brenn/kicad-filament-dryer/kicad/datasheets/MiniLCD-dimensions.gif

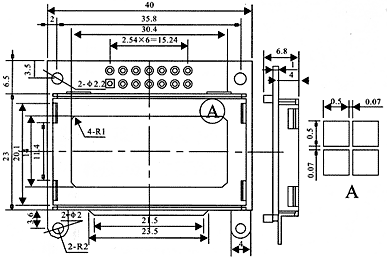
kicad/datasheets/MiniLCD-dimensions.gif
