brenn/kicad-filament-dryer/kicad/filament-dryer.kicad_pcb

## KiCad design kicad/filament-dryer.kicad_pcb (2026-08-02)

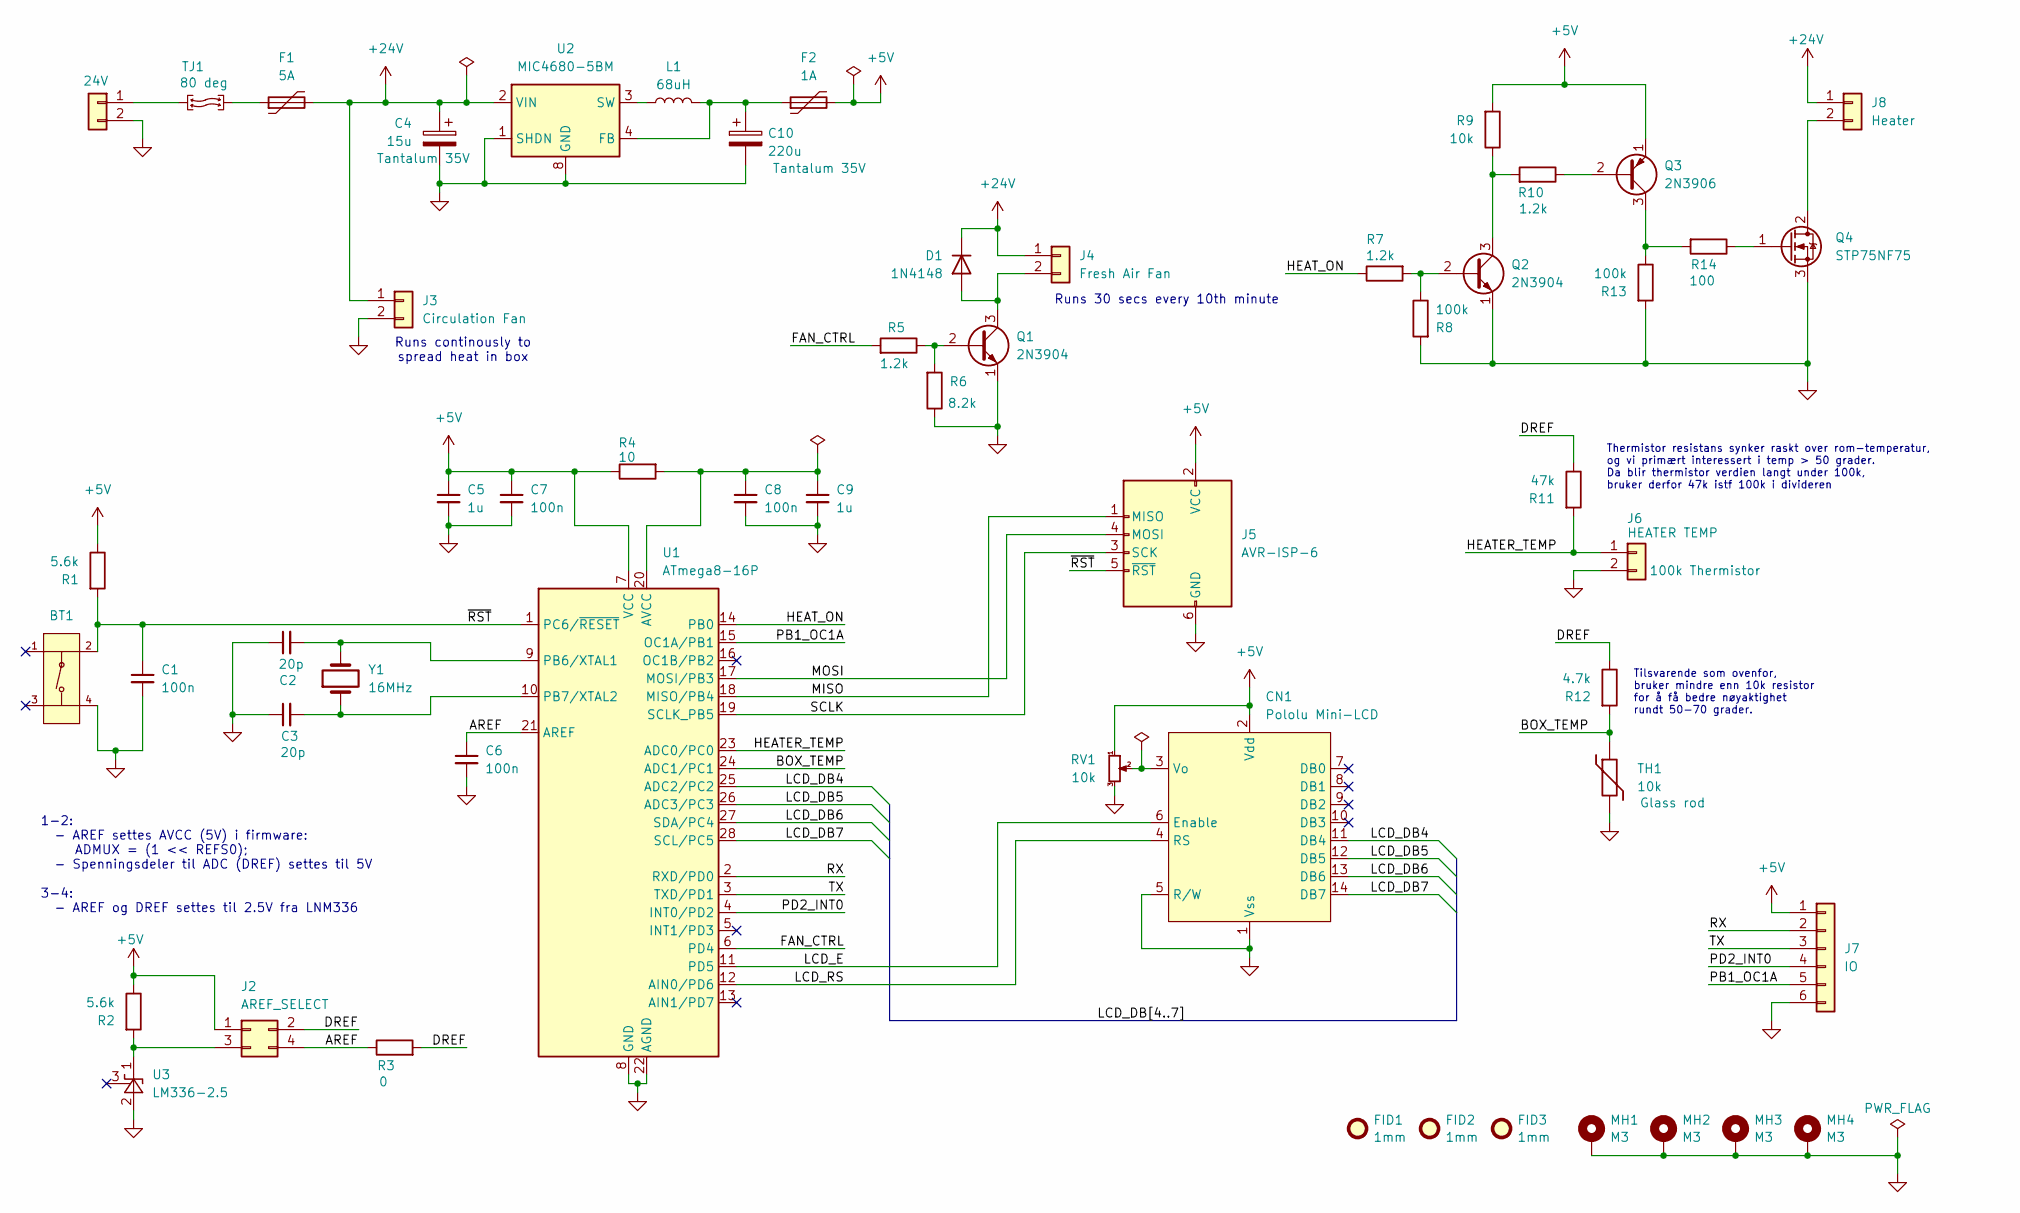
[picture p2: schematic filament-dryer.kicad_sch, Filament Dryer]

Parts:
BT1: Tactile Button; PushButton-SMD_4P-L5.1-W5.1; Voltage Rating (Dc) 12V; Part TS-1187A-B-A-B; LCSC C318884
C1, C6, C7, C8: 100n; C_Disc_D4.3mm_W1.9mm_P5.00mm
C2, C3: 20p; C_Disc_D4.3mm_W1.9mm_P5.00mm
C4: 15u; CP_EIA-6032-28_Kemet-C
C5, C9: 1u; CP_EIA-6032-20_AVX-F
C10: 220u; CP_EIA-6032-28_Kemet-C
CN1: Pololu Mini-LCD; PinHeader_2x07_P2.54mm_Vertical
D1: 1N4148; D_DO-35_SOD27_P7.62mm_Horizontal
F1: 5A; FuseHolder_20x5mm
F2: 1A; Fuse_1206_3216Metric_Pad1.42x1.75mm_HandSolder
FID1, FID2, FID3: 1mm; Fiducial_1mm_Mask2mm
J1: 24V; TerminalBlock_2_P5.08mm
J2: AREF_SELECT; PinHeader_2x02_P2.54mm_Vertical
J3: Circulation Fan; PinHeader_1x02_P2.54mm_Vertical
J4: Fresh Air Fan; PinHeader_1x02_P2.54mm_Vertical
J5: AVR-ISP-6; PinHeader_2x03_P2.54mm_Vertical
J6: HEATER TEMP; JST_PH_B2B-PH-K_1x02_P2.00mm_Vertical
J7: IO; PinHeader_1x06_P2.54mm_Vertical
J8: Heater; TerminalBlock_2_P5.08mm
L1: 68uH; L_12x12mm_H6mm
MH1, MH2, MH3, MH4: M3; MountingHole_3.2mm_M3_Pad_Via
Q1, Q2: 2N3904; TO-92_Inline
Q3: 2N3906; TO-92_Inline
Q4: STP75NF75; TO-220-3_Vertical
R1, R2: 5.6k; R_Axial_DIN0207_L6.3mm_D2.5mm_P10.16mm_Horizontal
R3: 0; R_Axial_DIN0207_L6.3mm_D2.5mm_P10.16mm_Horizontal
R4: 10; R_Axial_DIN0207_L6.3mm_D2.5mm_P10.16mm_Horizontal
R5, R7, R10: 1.2k; R_Axial_DIN0207_L6.3mm_D2.5mm_P10.16mm_Horizontal
R6: 8.2k; R_Axial_DIN0207_L6.3mm_D2.5mm_P10.16mm_Horizontal
R8, R13: 100k; R_Axial_DIN0207_L6.3mm_D2.5mm_P10.16mm_Horizontal
R9: 10k; R_Axial_DIN0207_L6.3mm_D2.5mm_P10.16mm_Horizontal
R11: 47k; R_Axial_DIN0207_L6.3mm_D2.5mm_P10.16mm_Horizontal
R12: 4.7k; R_Axial_DIN0207_L6.3mm_D2.5mm_P10.16mm_Horizontal
R14: 100; R_Axial_DIN0207_L6.3mm_D2.5mm_P10.16mm_Horizontal
RV1: 10k; Potentiometer_VANXY_T73YP_Vertical
TH1: 10k; R_Axial_DIN0207_L6.3mm_D2.5mm_P10.16mm_Horizontal
TJ1: 80 deg; SolderWire-0.75sqmm_1x02_P7mm_D1.25mm_OD3.5mm
U1: ATmega8-16P; DIP-28_W7.62mm
U2: MIC4680-5BM; SOIC-8_3.9x4.9mm_P1.27mm
U3: LM336-2.5; TO-92L_Inline
Y1: 16MHz; Crystal_HC49-4H_Vertical

Connections:
+5V: C5.1, C7.1, CN1.2 (Vdd), F2.2, J2.1, J5.2 (VCC), J7.1, Q3.1 (E), R1.1, R2.1, R4.1, R9.2, RV1.1, U1.7 (VCC)
+24V: C4.1, D1.1 (K), F1.2, J3.1, J4.1, J8.1, U2.2 (VIN)
/AREF: C6.1, J2.4, R3.1, U1.21 (AREF)
/BOX_TEMP: R12.2, TH1.1, U1.24 (ADC1/PC1)
/DREF: J2.2, R3.2, R11.1, R12.1
/FAN_CTRL: R5.2, U1.6 (PD4)
/HEATER_TEMP: J6.1, R11.2, U1.23 (ADC0/PC0)
/HEAT_ON: R7.1, U1.14 (PB0)
/LCD_DB4: CN1.11 (DB4), U1.25 (ADC2/PC2)
/LCD_DB5: CN1.12 (DB5), U1.26 (ADC3/PC3)
/LCD_DB6: CN1.13 (DB6), U1.27 (SDA/PC4)
/LCD_DB7: CN1.14 (DB7), U1.28 (SCL/PC5)
/LCD_E: CN1.6 (Enable), U1.11 (PD5)
/LCD_RS: CN1.4 (RS), U1.12 (AIN0/PD6)
/MISO: J5.1 (MISO), U1.18 (MISO/PB4)
/MOSI: J5.4 (MOSI), U1.17 (MOSI/PB3)
/PB1_OC1A: J7.5, U1.15 (OC1A/PB1)
/PD2_INT0: J7.4, U1.4 (INT0/PD2)
/RX: J7.2, U1.2 (RXD/PD0)
/SCLK: J5.3 (SCK), U1.19 (SCLK_PB5)
/TX: J7.3, U1.3 (TXD/PD1)
/~RST: BT1.2 (B), C1.1, J5.5 (~RST), R1.2, U1.1 (PC6/~RESET)
unnamed: CN1.3 (Vo), RV1.2
unnamed: D1.2 (A), J4.2, Q1.3 (C)
unnamed: J1.1, TJ1.1 (Pin1)
unnamed: J2.3, R2.2, U3.1 (K)
unnamed: J8.2, Q4.2 (D)
unnamed: Q1.2 (B), R5.1, R6.2
unnamed: Q2.2 (B), R7.2, R8.1
unnamed: Q2.3 (C), R9.1, R10.2
unnamed: Q3.2 (B), R10.1
unnamed: Q3.3 (C), R13.1, R14.2
unnamed: Q4.1 (G), R14.1
unnamed: F1.1, TJ1.2 (Pin2)
unnamed: C8.1, C9.1, R4.2, U1.20 (AVCC)
unnamed: C2.2, U1.9 (PB6/XTAL1), Y1.2
unnamed: C3.2, U1.10 (PB7/XTAL2), Y1.1
unnamed: C10.1, F2.1, L1.2, U2.4 (FB)
unnamed: L1.1, U2.3 (SW)

Notes on the sheet:
1-2: - AREF settes AVCC (5V) i firmware: ADMUX = (1 << REFS0); - Spenningsdeler til ADC (DREF) settes til 5V 3-4: - AREF og DREF settes til 2.5V fra LNM336
Runs continously to spread heat in box
Tilsvarende som ovenfor, bruker mindre enn 10k resistor for å få bedre nøyaktighet rundt 50-70 grader.
Runs 30 secs every 10th minute
Thermistor resistans synker raskt over rom-temperatur, og vi primært interessert i temp > 50 grader. Da blir thermistor verdien langt under 100k, bruker derfor 47k istf 100k i divideren

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
Board: 2 copper layers, 56 parts (0 on the bottom side), 40 nets, no tracks yet.
