brenn/kicad-filament-dryer/kicad/measurements.ods

R (kOhm) | Temp
17.5 | 68
17.9 | 67
18.2 | 68
19 | 67
20 | 65
20.5 | 65
22.5 | 64
22.5 | 61
25 | 60
25.2 | 60.5
26.3 | 59.5
27.6 | 58.5
27.7 | 58
27.8 | 60
29.6 | 57.8
31.2 | 55
33 | 57
36 | 55
40 | 46
47 | 44
50 | 42
50 | 41
54 | 39
60 | 35
62.5 | 39
83.1 | 32
96.5 | 26
