brenn/kicad-filament-dryer/(commit log)

2026-07-24 schematic done, ready for pcb layout
    [filament-dryer.kicad_sch]
2026-07-25 added fuses and fans, ready for layout
    [filament-dryer.kicad_sch]
2026-08-02 fan-control transistor, resistor values in mosfet driver
    [filament-dryer.kicad_sch]
2026-08-02 Ready for pcb layout
2026-08-02 Component placement done
    [filament-dryer.kicad_pcb, filament-dryer.kicad_sch]
2026-08-06 Created buck with MC34063 for 13.2v
    [filament-dryer.kicad_sch]
